zhiyb/portal_lights/pcb/ingress-svgrepo-com-edited.png

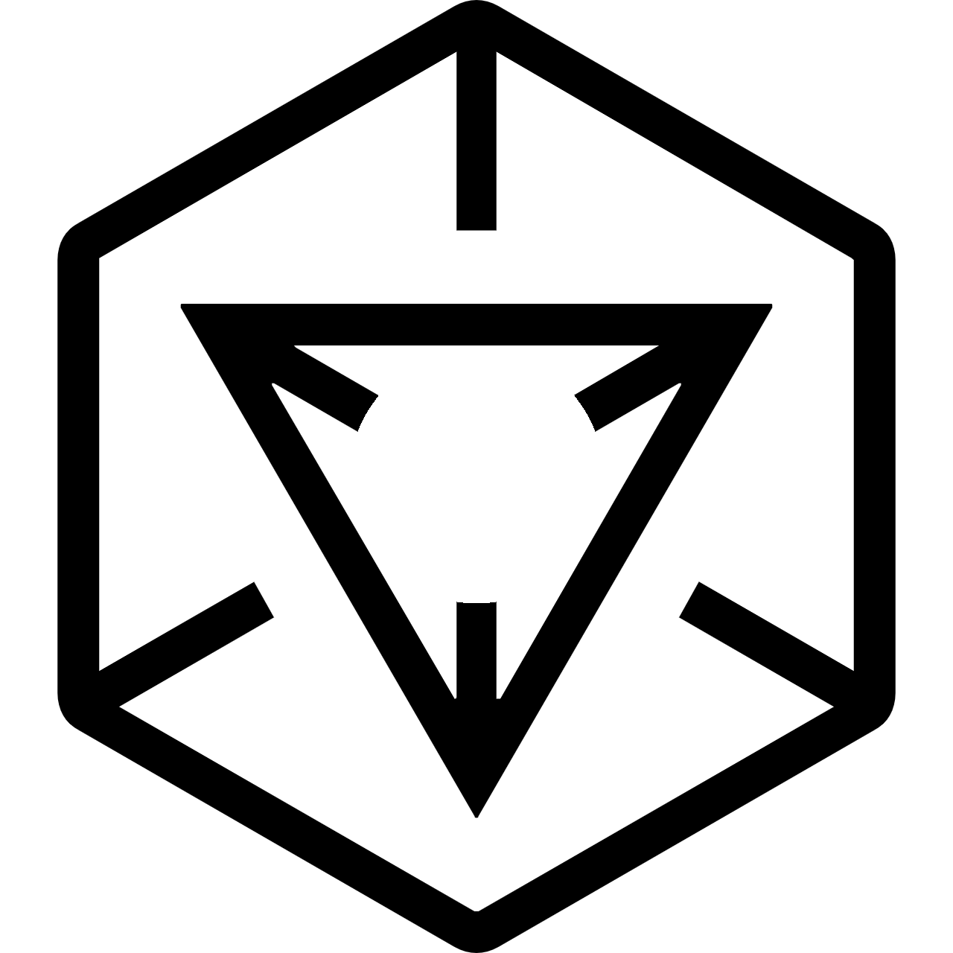
pcb/ingress-svgrepo-com-edited.png
