zhiyb/portal_lights/pcb/portal_lights.kicad_pcb

## KiCad design pcb/portal_lights.kicad_pcb (2023-07-24)

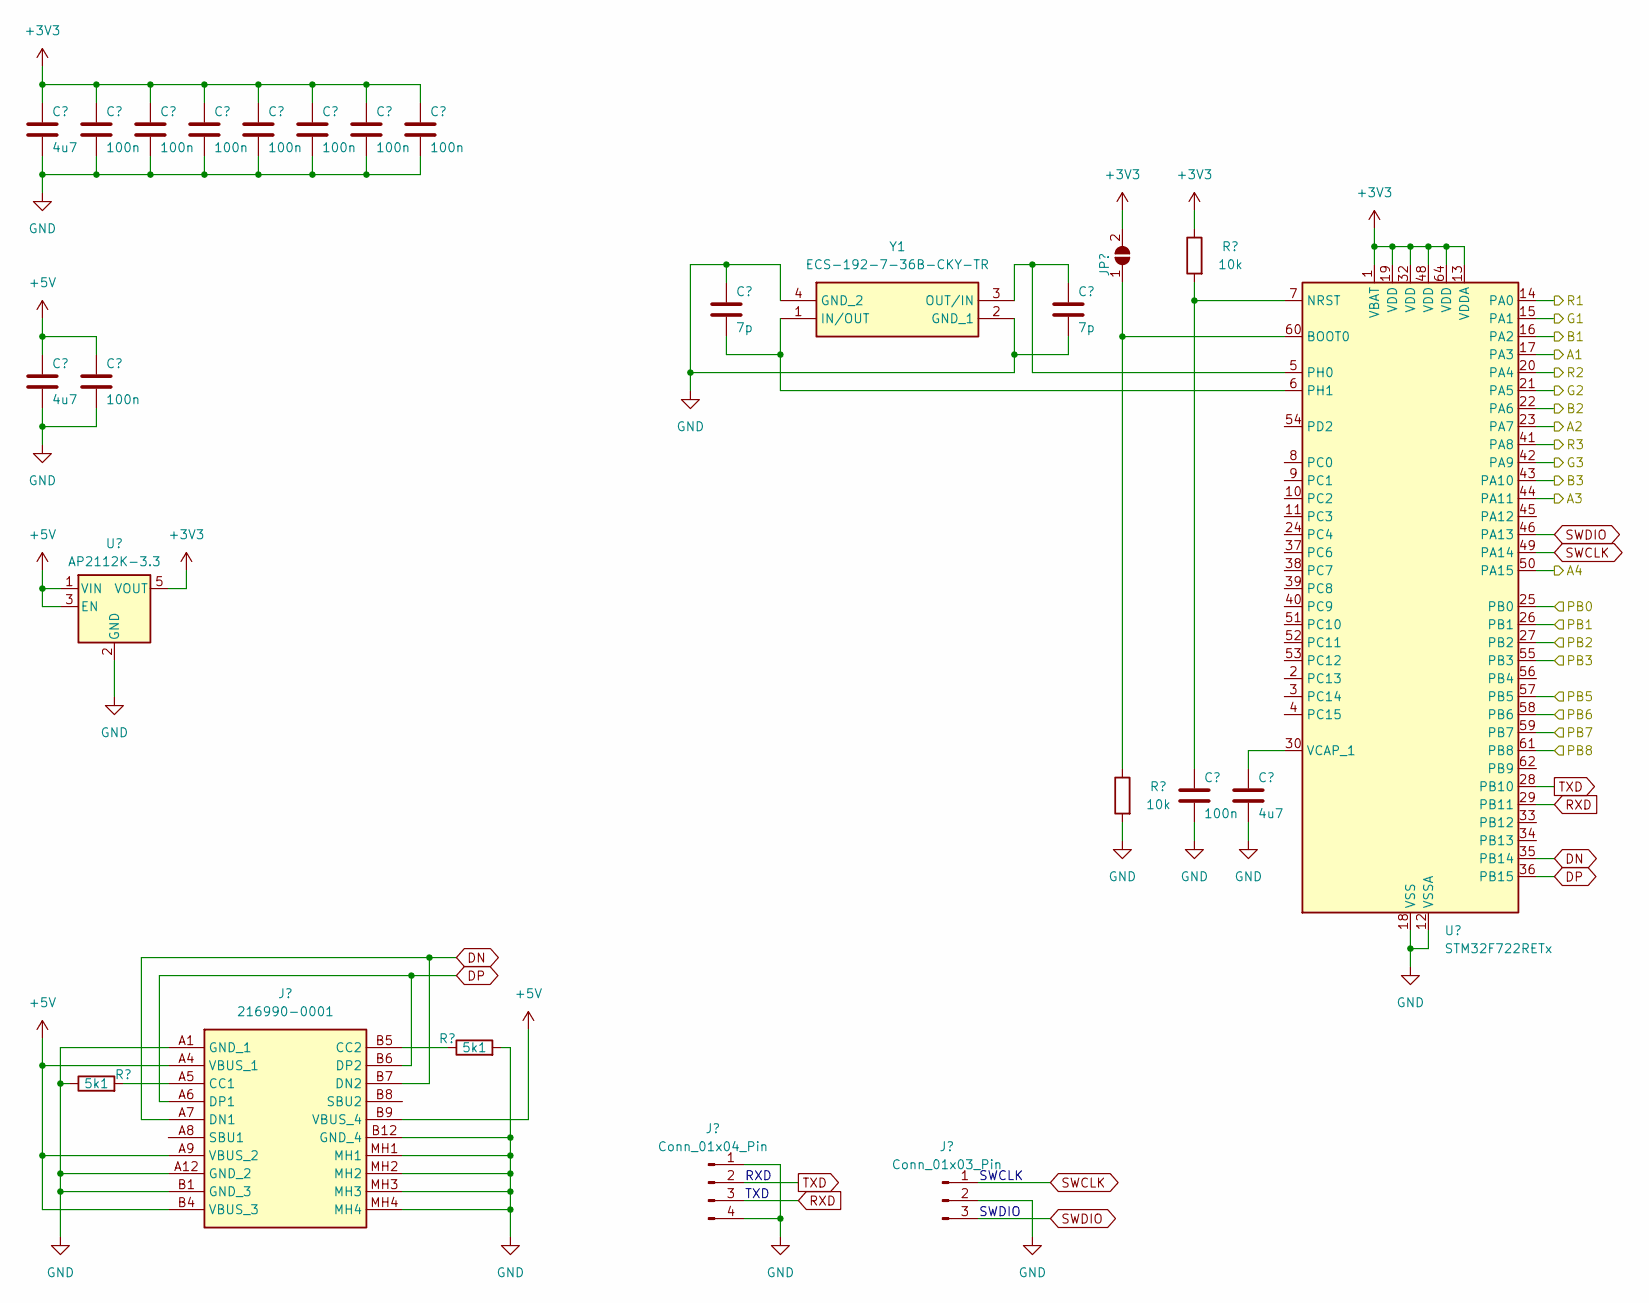
[picture p2: schematic mcu.kicad_sch]

Parts:
C1, C11, C14: 4u7; C_0402_1005Metric_Pad0.74x0.62mm_HandSolder
C2, C3, C4, C5, C6, C7, C8, C12, C13: 100n; C_0402_1005Metric_Pad0.74x0.62mm_HandSolder
C9, C10: 7p; C_0402_1005Metric_Pad0.74x0.62mm_HandSolder
J1: 216990-0001; 2169900001; Mouser Part Number 538-216990-0001
J2: Conn_01x04_Pin; PinHeader_1x04_P2.54mm_Vertical
J3: Conn_01x03_Pin; PinHeader_1x03_P2.54mm_Vertical
JP1: SolderJumper_2_Open; SolderJumper-2_P1.3mm_Open_RoundedPad1.0x1.5mm
R1, R2: 10k; R_0402_1005Metric_Pad0.72x0.64mm_HandSolder
R3, R4: 5k1; R_0402_1005Metric_Pad0.72x0.64mm_HandSolder
U1: AP2112K-3.3; SOT-23-5_HandSoldering
U2: STM32F722RETx; LQFP-64_10x10mm_P0.5mm
Y1: ECS-192-7-36B-CKY-TR; ECS192736BCKYTR; Mouser Part Number 520-192-7-36B-CKYT

Connections:
+3V3: C1.1, C2.1, C3.1, C4.1, C5.1, C6.1, C7.1, C8.1, JP1.2 (B), R1.1, U1.5 (VOUT), U2.1 (VBAT), U2.13 (VDDA), U2.19 (VDD), U2.32 (VDD), U2.48 (VDD), U2.64 (VDD); also elsewhere on the board
+5V: C11.1, C12.1, J1.A4 (VBUS_1), J1.A9 (VBUS_2), J1.B4 (VBUS_3), J1.B9 (VBUS_4), U1.1 (VIN), U1.3 (EN)
/IO/PB1: U2.25 (PB0); also elsewhere on the board
/IO/PB2: U2.26 (PB1); also elsewhere on the board
/IO/PB3: U2.27 (PB2); also elsewhere on the board
/IO/PB4: U2.55 (PB3); also elsewhere on the board
/IO/TB1: U2.57 (PB5); also elsewhere on the board
/IO/TB2: U2.58 (PB6); also elsewhere on the board
/IO/TB3: U2.59 (PB7); also elsewhere on the board
/IO/TB4: U2.61 (PB8); also elsewhere on the board
/Lights/A1: U2.17 (PA3); also elsewhere on the board
/Lights/A2: U2.23 (PA7); also elsewhere on the board
/Lights/A3: U2.44 (PA11); also elsewhere on the board
/Lights/A4: U2.50 (PA15); also elsewhere on the board
/Lights/B1: U2.16 (PA2); also elsewhere on the board
/Lights/B2: U2.22 (PA6); also elsewhere on the board
/Lights/B3: U2.43 (PA10); also elsewhere on the board
/Lights/G1: U2.15 (PA1); also elsewhere on the board
/Lights/G2: U2.21 (PA5); also elsewhere on the board
/Lights/G3: U2.42 (PA9); also elsewhere on the board
/Lights/R1: U2.14 (PA0); also elsewhere on the board
/Lights/R2: U2.20 (PA4); also elsewhere on the board
/Lights/R3: U2.41 (PA8); also elsewhere on the board
DN: J1.A7 (DN1), J1.B7 (DN2), U2.35 (PB14)
DP: J1.A6 (DP1), J1.B6 (DP2), U2.36 (PB15)
GND: C1.2, C2.2, C3.2, C4.2, C5.2, C6.2, C7.2, C8.2, C9.1, C10.2, C11.2, C12.2, C13.2, C14.2, J1.A1 (GND_1), J1.A12 (GND_2), J1.B1 (GND_3), J1.B12 (GND_4), J1.MH1, J1.MH2, J1.MH3, J1.MH4, J2.1, J2.4, J3.2, R2.2, R3.2, R4.1, U1.2 (GND), U2.12 (VSSA), U2.18 (VSS), U2.31 (VSS), U2.47 (VSS), U2.63 (VSS), Y1.2 (GND_1), Y1.4 (GND_2); also elsewhere on the board
unnamed: J1.A5 (CC1), R4.2
unnamed: J1.B5 (CC2), R3.1
unnamed: JP1.1 (A), R2.1, U2.60 (BOOT0)
unnamed: C13.1, R1.2, U2.7 (NRST)
unnamed: C10.1, U2.5 (PH0), Y1.3 (OUT/IN)
unnamed: C9.2, U2.6 (PH1), Y1.1 (IN/OUT)
unnamed: C14.1, U2.30 (VCAP_1)
RXD: J2.3, U2.29 (PB11)
SWCLK: J3.1, U2.49 (PA14)
SWDIO: J3.3, U2.46 (PA13)
TXD: J2.2, U2.28 (PB10)

Notes on the sheet:
RXD
SWCLK
TXD
SWDIO

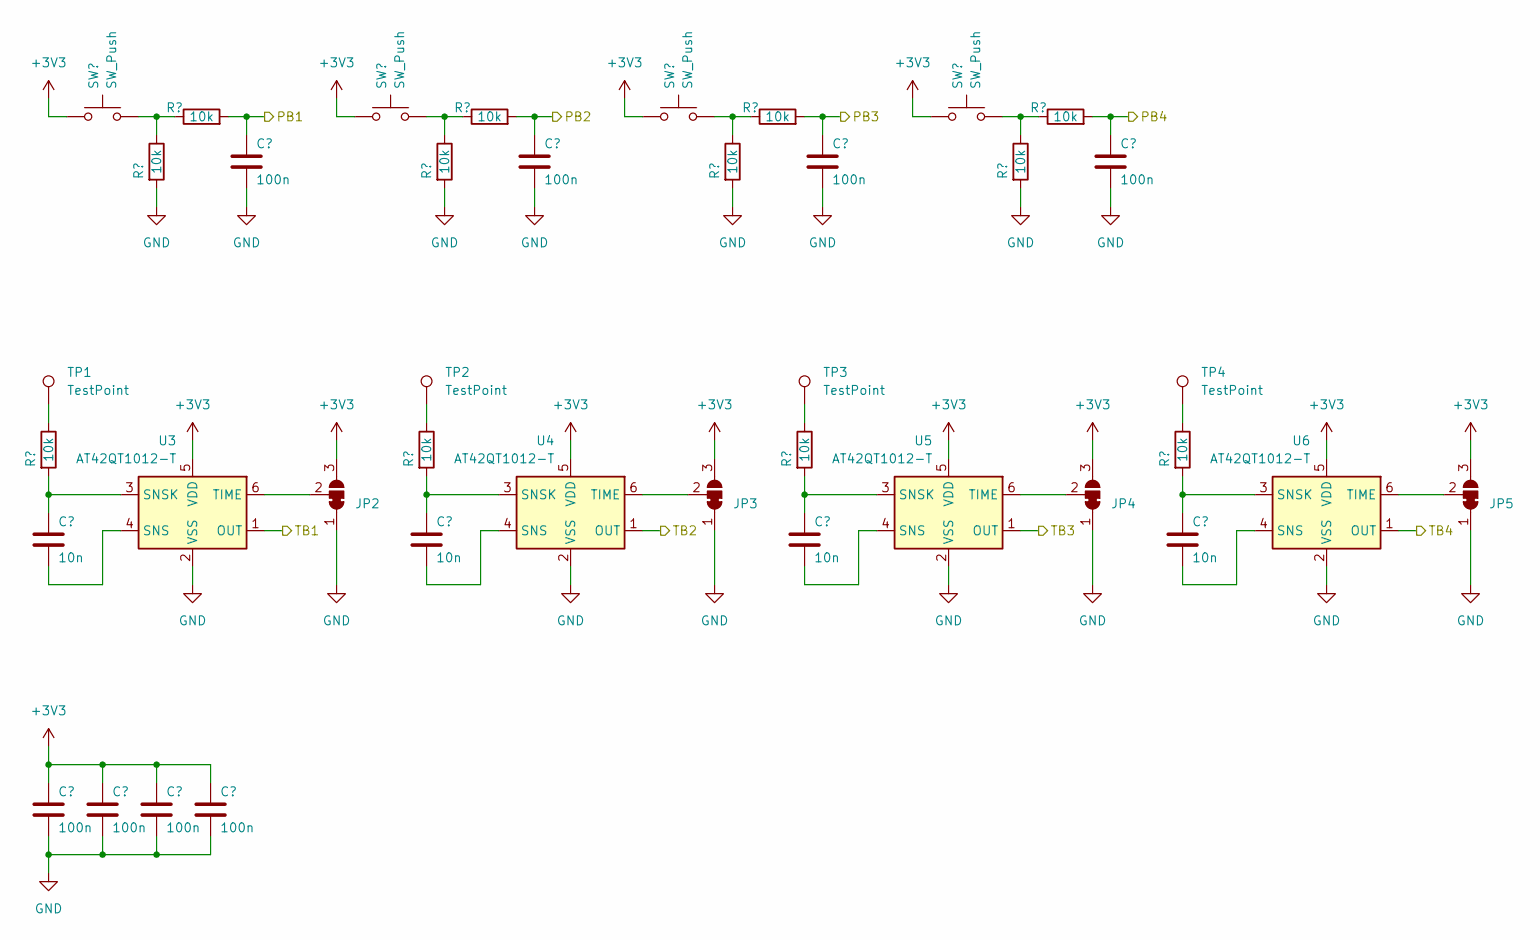
[picture p3: schematic io.kicad_sch]

Parts:
C15, C16, C17, C18, C23, C24, C25, C26: 100n; C_0402_1005Metric_Pad0.74x0.62mm_HandSolder
C19, C20, C21, C22: 10n; C_0402_1005Metric_Pad0.74x0.62mm_HandSolder
JP2, JP3, JP4, JP5: SolderJumper_3_Bridged12; SolderJumper-3_P1.3mm_Bridged12_RoundedPad1.0x1.5mm
R5, R6, R7, R8, R9, R10, R11, R12, R13, R14, R15, R16: 10k; R_0402_1005Metric_Pad0.72x0.64mm_HandSolder
SW1, SW2, SW3, SW4: SW_Push; SW_Push_1P1T_NO_6x6mm_H9.5mm
TP1, TP2, TP3, TP4: TestPoint; TestPoint_Pad_D4.0mm
U3, U4, U5, U6: AT42QT1012-T; SOT-23-6

Connections:
+3V3: C23.1, C24.1, C25.1, C26.1, JP2.3 (B), JP3.3 (B), JP4.3 (B), JP5.3 (B), SW1.1, SW2.1, SW3.1, SW4.1, U3.5 (VDD), U4.5 (VDD), U5.5 (VDD), U6.5 (VDD); also elsewhere on the board
/IO/PB1: C15.1, R5.2; also elsewhere on the board
/IO/PB2: C16.1, R6.2; also elsewhere on the board
/IO/PB3: C17.1, R7.2; also elsewhere on the board
/IO/PB4: C18.1, R8.2; also elsewhere on the board
/IO/TB1: U3.1 (OUT); also elsewhere on the board
/IO/TB2: U4.1 (OUT); also elsewhere on the board
/IO/TB3: U5.1 (OUT); also elsewhere on the board
/IO/TB4: U6.1 (OUT); also elsewhere on the board
GND: C15.2, C16.2, C17.2, C18.2, C23.2, C24.2, C25.2, C26.2, JP2.1 (A), JP3.1 (A), JP4.1 (A), JP5.1 (A), R9.2, R10.2, R11.2, R12.2, U3.2 (VSS), U4.2 (VSS), U5.2 (VSS), U6.2 (VSS); also elsewhere on the board
unnamed: JP2.2 (C), U3.6 (TIME)
unnamed: JP3.2 (C), U4.6 (TIME)
unnamed: JP4.2 (C), U5.6 (TIME)
unnamed: JP5.2 (C), U6.6 (TIME)
unnamed: R5.1, R9.1, SW1.2
unnamed: R6.1, R10.1, SW2.2
unnamed: R7.1, R11.1, SW3.2
unnamed: R8.1, R12.1, SW4.2
unnamed: R13.1, TP1.1
unnamed: R14.1, TP2.1
unnamed: R15.1, TP3.1
unnamed: R16.1, TP4.1
unnamed: C19.2, U3.4 (SNS)
unnamed: C19.1, R13.2, U3.3 (SNSK)
unnamed: C20.2, U4.4 (SNS)
unnamed: C20.1, R14.2, U4.3 (SNSK)
unnamed: C21.2, U5.4 (SNS)
unnamed: C21.1, R15.2, U5.3 (SNSK)
unnamed: C22.2, U6.4 (SNS)
unnamed: C22.1, R16.2, U6.3 (SNSK)

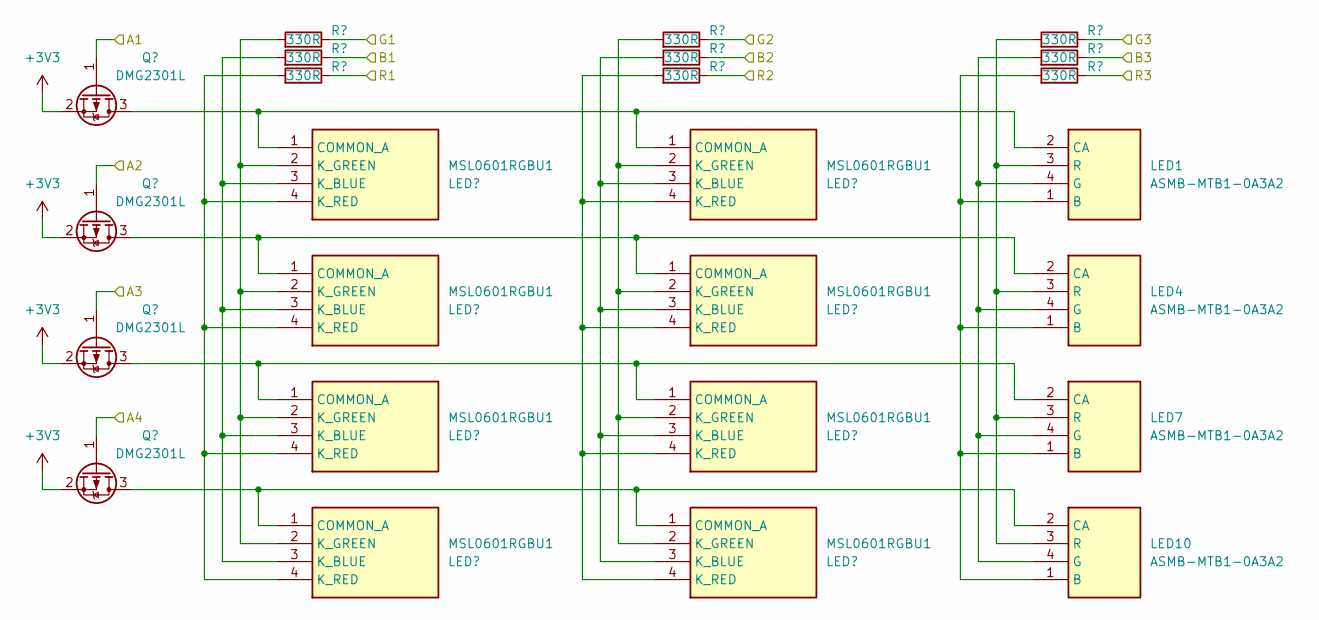
[picture p4: schematic lights.kicad_sch]

Parts:
LED1, LED4, LED7, LED10: ASMB-MTB1-0A3A2; HSMFA341A00J1; Mouser Part Number 630-HSMF-A341-A00J1
LED2, LED3, LED5, LED6, LED8, LED9, LED11, LED12: MSL0601RGBU1; Mouser Part Number 755-MSL0601RGBU1
Q1, Q2, Q3, Q4: DMG2301L; SOT-23
R17, R18, R19, R20, R21, R22, R23, R24, R25: 330R; R_0402_1005Metric_Pad0.72x0.64mm_HandSolder

Connections:
+3V3: Q1.2 (S), Q2.2 (S), Q3.2 (S), Q4.2 (S); also elsewhere on the board
/Lights/A1: Q1.1 (G); also elsewhere on the board
/Lights/A2: Q2.1 (G); also elsewhere on the board
/Lights/A3: Q3.1 (G); also elsewhere on the board
/Lights/A4: Q4.1 (G); also elsewhere on the board
/Lights/B1: R20.1; also elsewhere on the board
/Lights/B2: R21.1; also elsewhere on the board
/Lights/B3: R22.1; also elsewhere on the board
/Lights/G1: R17.1; also elsewhere on the board
/Lights/G2: R18.1; also elsewhere on the board
/Lights/G3: R19.1; also elsewhere on the board
/Lights/R1: R23.1; also elsewhere on the board
/Lights/R2: R24.1; also elsewhere on the board
/Lights/R3: R25.1; also elsewhere on the board
unnamed: LED1.1 (B), LED4.1 (B), LED7.1 (B), LED10.1 (B), R25.2
unnamed: LED1.2 (CA), LED2.1 (COMMON_A), LED3.1 (COMMON_A), Q1.3 (D)
unnamed: LED1.4 (G), LED4.4 (G), LED7.4 (G), LED10.4 (G), R22.2
unnamed: LED1.3 (R), LED4.3 (R), LED7.3 (R), LED10.3 (R), R19.2
unnamed: LED4.2 (CA), LED5.1 (COMMON_A), LED6.1 (COMMON_A), Q2.3 (D)
unnamed: LED7.2 (CA), LED8.1 (COMMON_A), LED9.1 (COMMON_A), Q3.3 (D)
unnamed: LED10.2 (CA), LED11.1 (COMMON_A), LED12.1 (COMMON_A), Q4.3 (D)
unnamed: LED2.3 (K_BLUE), LED5.3 (K_BLUE), LED8.3 (K_BLUE), LED11.3 (K_BLUE), R20.2
unnamed: LED2.2 (K_GREEN), LED5.2 (K_GREEN), LED8.2 (K_GREEN), LED11.2 (K_GREEN), R17.2
unnamed: LED2.4 (K_RED), LED5.4 (K_RED), LED8.4 (K_RED), LED11.4 (K_RED), R23.2
unnamed: LED3.3 (K_BLUE), LED6.3 (K_BLUE), LED9.3 (K_BLUE), LED12.3 (K_BLUE), R21.2
unnamed: LED3.2 (K_GREEN), LED6.2 (K_GREEN), LED9.2 (K_GREEN), LED12.2 (K_GREEN), R18.2
unnamed: LED3.4 (K_RED), LED6.4 (K_RED), LED9.4 (K_RED), LED12.4 (K_RED), R24.2

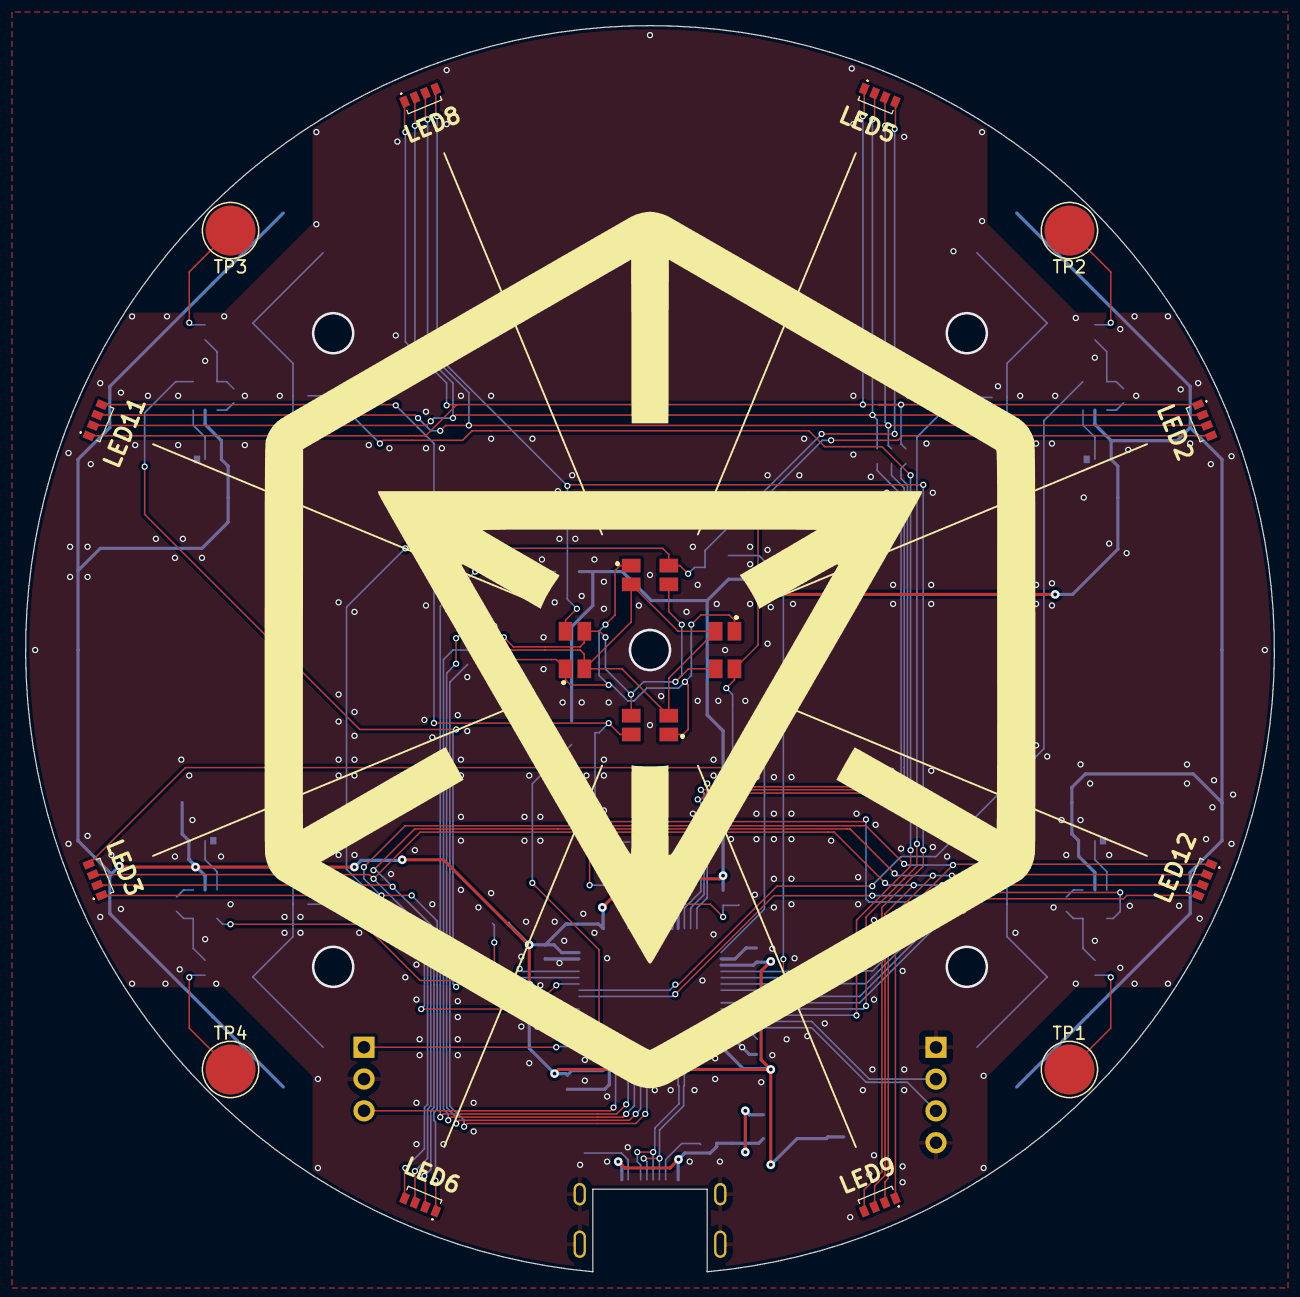
[picture p5: board portal_lights.kicad_pcb from above]

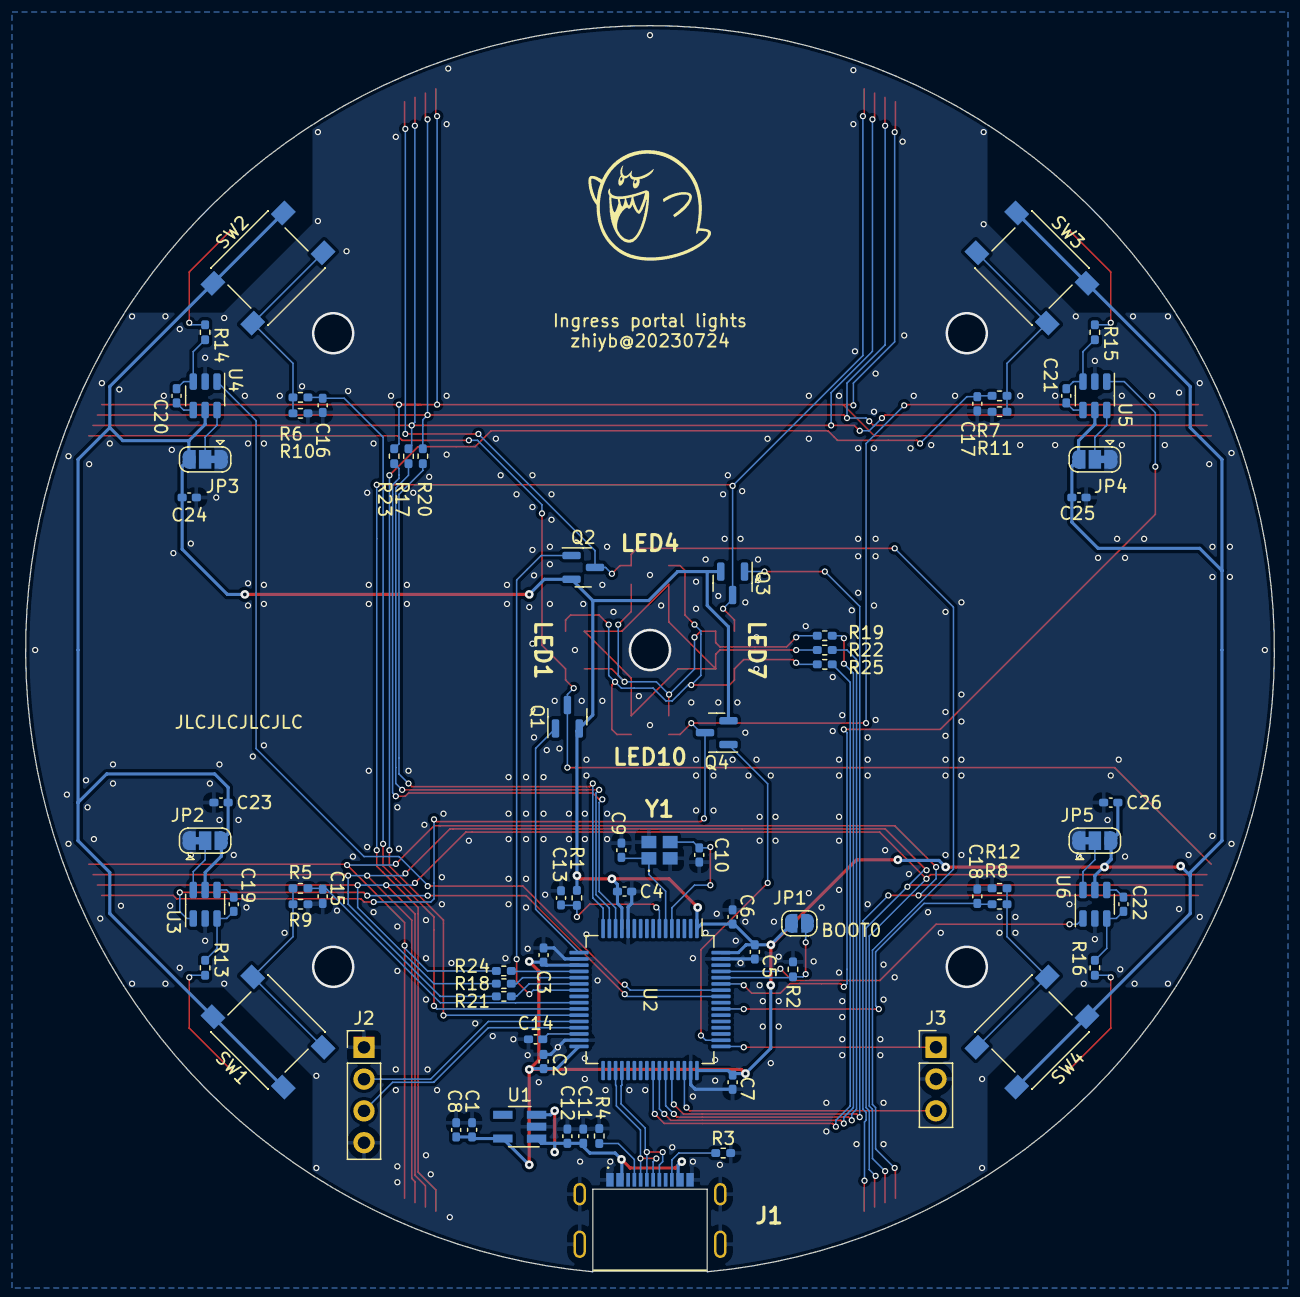
[picture p6: board portal_lights.kicad_pcb from below]

Board: 2 copper layers, 99.8 x 99.6 mm, 90 parts (74 on the bottom side), 70 nets.
