zhiyb/portal_lights/stm32f7/portal_lights.ioc

Mcu.UserName=STM32F722RETx
PA13.Signal=SYS_JTMS-SWDIO
PA14.Signal=SYS_JTCK-SWCLK
PB10.Signal=USART3_TX
PB11.Signal=USART3_RX
PB14.Signal=USB_OTG_HS_DM
PB15.Signal=USB_OTG_HS_DP
PH0-OSC_IN.Signal=RCC_OSC_IN
PH1-OSC_OUT.Signal=RCC_OSC_OUT
