zhiyb/portal_lights/(commit log)

2023-07-23 portal_lights initial design
    [io.kicad_sch, lights.kicad_sch, mcu.kicad_sch, portal_lights.kicad_pcb, portal_lights.kicad_sch]
2023-07-24 Updates for release v20230724
    [portal_lights.kicad_pcb, portal_lights.kicad_sch]
2023-08-04 Fix RGB LED part # should be ASMB-MTB1-0A3A2
    [lights.kicad_sch]
2023-08-04 Move PCB design to pcb subdirectory
    [io.kicad_sch, lights.kicad_sch, mcu.kicad_sch, portal_lights.kicad_pcb, portal_lights.kicad_sch]
2023-08-05 stm32f7: Rust initial project
2023-08-05 stm32f7: Add STM32 CubeMX project file for reference
2023-08-05 stm32f7: rcc initialisation
2023-08-05 stm32f7: Initial support for multiple linker scripts, bootloader
2023-08-05 pcb: Some notes about incorrect RGB LED footprint and connection
    [lights.kicad_sch]
2023-08-05 stm32f7: Minimal bootloader, RGB LED tests
2023-08-05 stm32f7: Button GPIO inputs
2023-08-06 stm32f7: RGB LED scan initial implementation using DMA
2023-08-06 stm32f7: Move some functions to utility.rs
2023-08-06 stm32f7: Increase LED greyscale to 1024 levels
